MichielfromNL/ESP8266IRFancontroller/images/Box 50x70.jpg

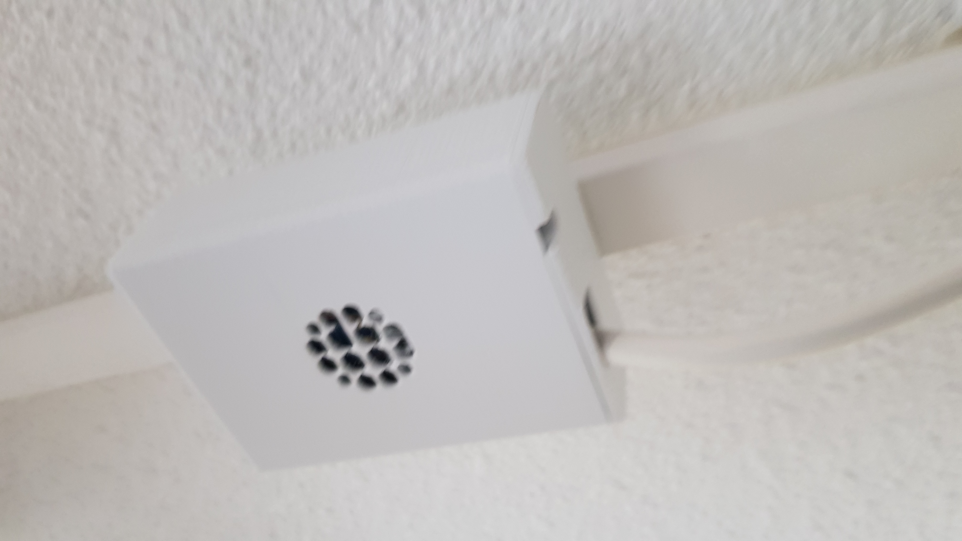
images/Box 50x70.jpg
