MichielfromNL/ESP8266IRFancontroller/images/Fan.jpg

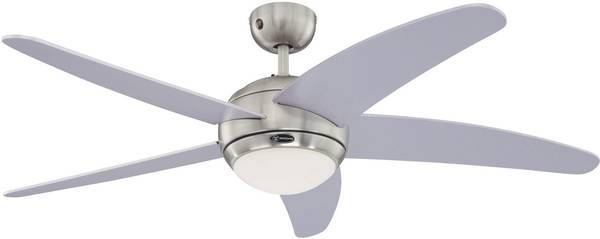
images/Fan.jpg
