MichielfromNL/ESP8266IRFancontroller/images/Main pic.jpg

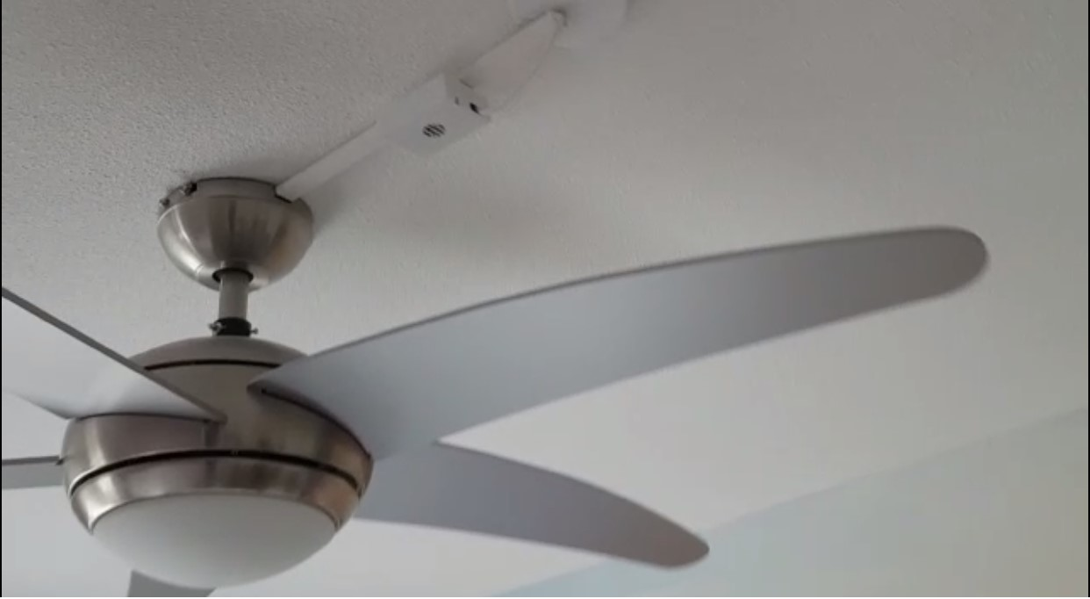
images/Main pic.jpg
