MichielfromNL/ESP8266IRFancontroller/images/Remote.jpg

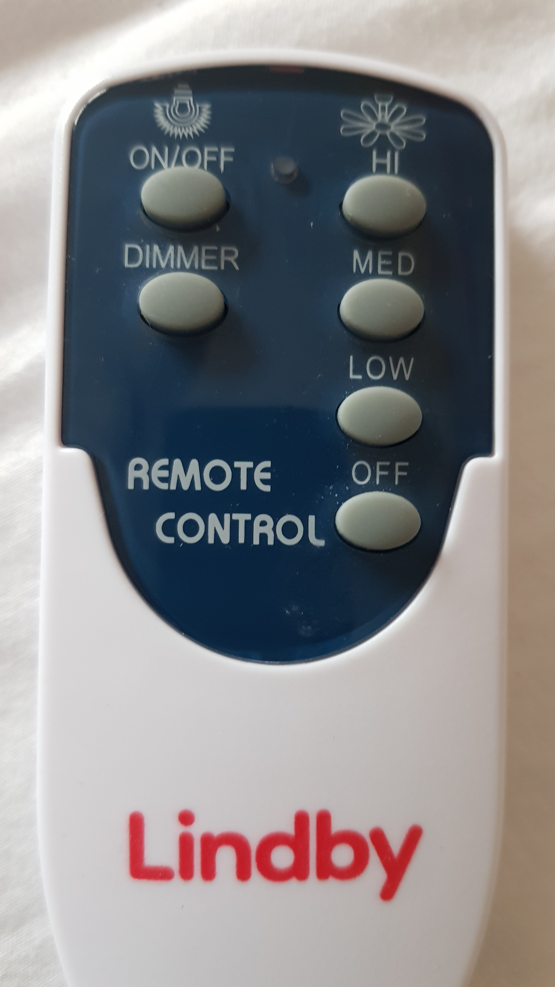
images/Remote.jpg
